adafruit/Adafruit-Bonsai-Buckaroo-PCB/Adafruit Bonsai Buckaroo.brd

## EAGLE design Adafruit Bonsai Buckaroo.brd (2020-03-19)

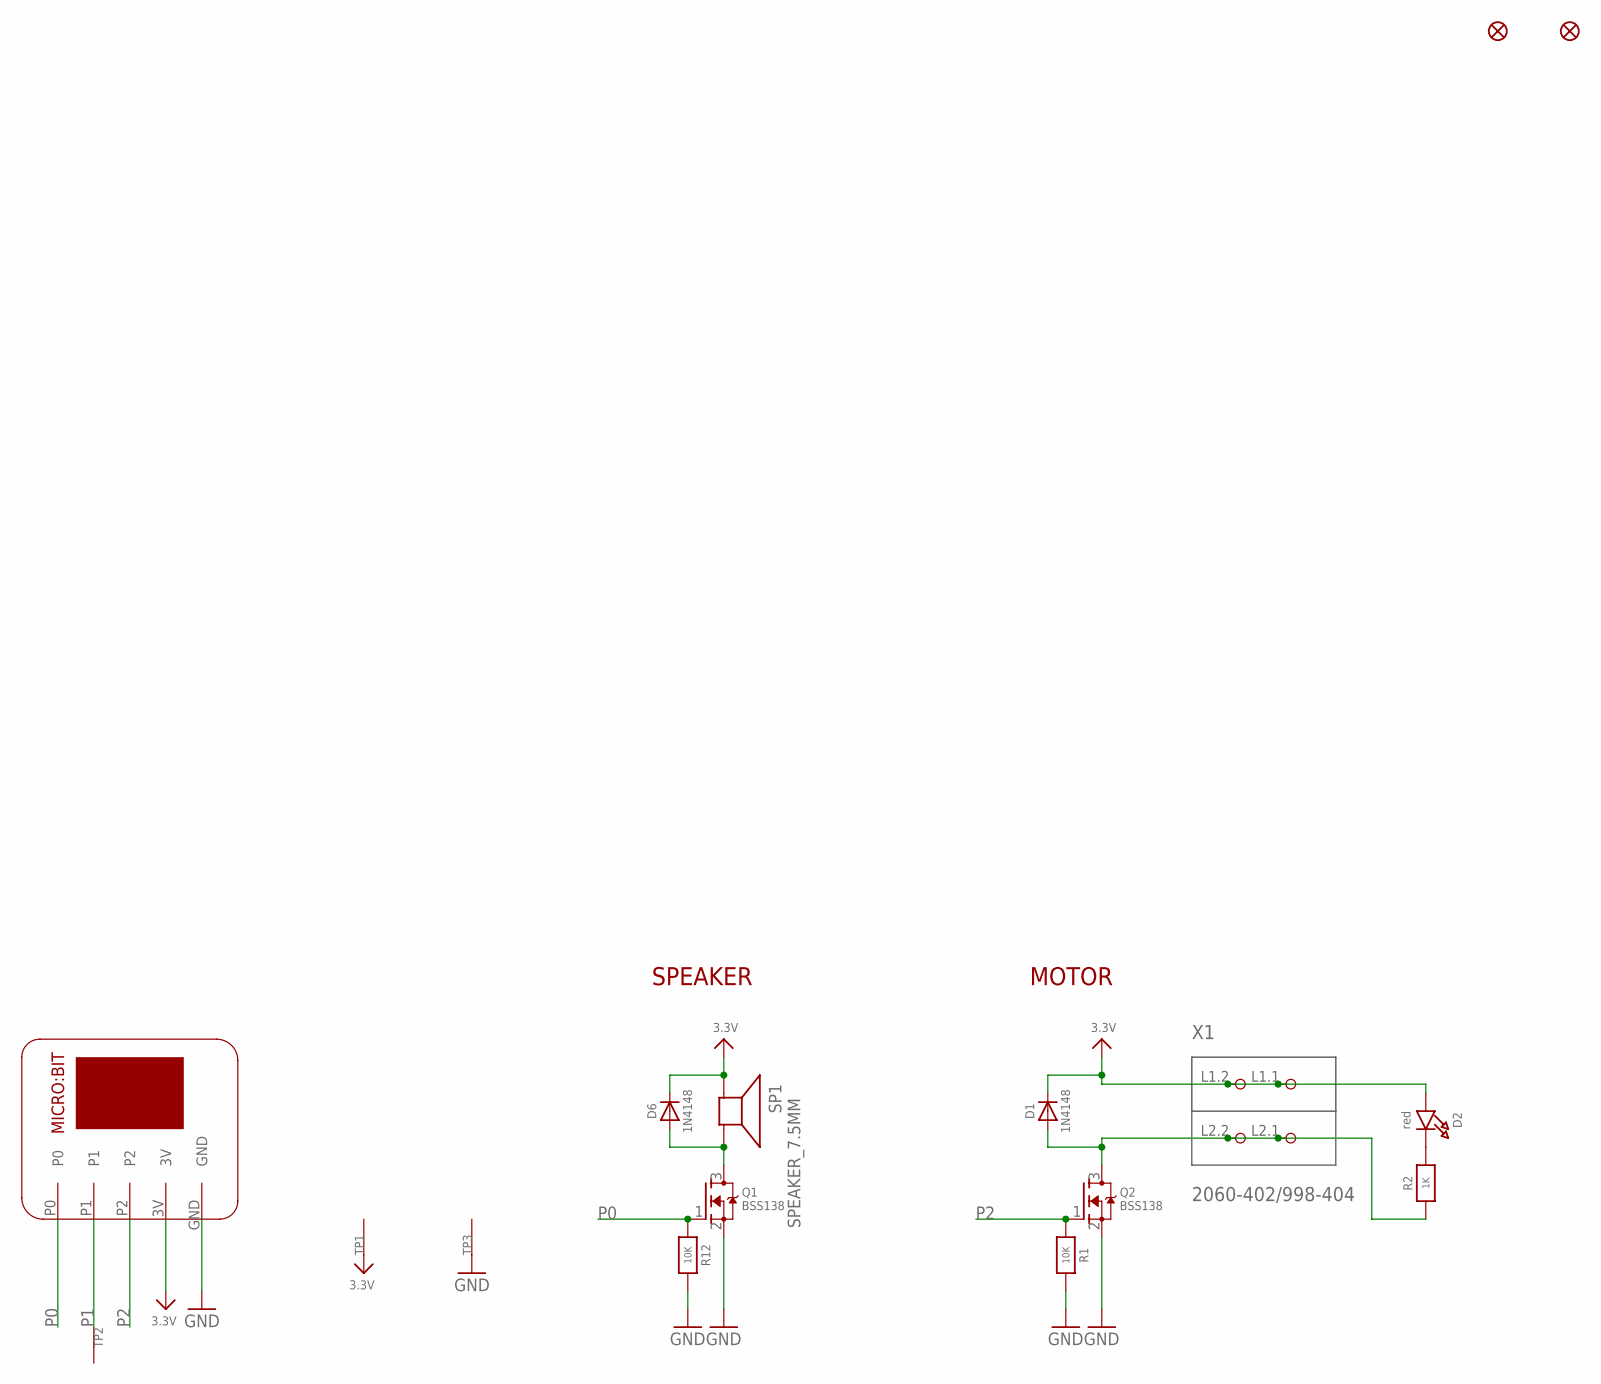
[picture p2: schematic Adafruit Bonsai Buckaroo.sch]

Parts:
D1, D6: 1N4148; SOD-323
D2: red; CHIPLED_0805_NOOUTLINE
FID1, FID2: FIDUCIAL_1MM
MB2: MICROBIT_5PIN; MICROBIT_5SMTNUT
Q1, Q2: BSS138; SOT23-WIDE
R1, R12: 10K; 0603-NO
R2: 1K; 0603-NO
SP1: SPEAKER_7.5MM; BUZZER_SMT_7.5MM
TP1, TP2, TP3: SEWTAPPCB_ALLIGATOR; PCB_ALLI
X1: 2060-402/998-404; P-2060-402/998-404

Connections:
3.3V: D1.C, D2.A, D6.C, MB2.3V, SP1.+, TP1.P$1, X1.L1.1 (P1.1), X1.L1.2 (P1.2)
GND: MB2.GND, Q1.2 (S), Q2.2 (S), R1.2, R12.2, TP3.P$1
unnamed: D1.A, Q2.3 (D), R2.1, X1.L2.1 (P2.1), X1.L2.2 (P2.2)
unnamed: D2.C, R2.2
unnamed: D6.A, Q1.3 (D), SP1.-
P0: MB2.P0, Q1.1 (G), R12.1
P1: MB2.P1, TP2.P$1
P2: MB2.P2, Q2.1 (G), R1.1

Notes on the sheet:
SPEAKER
MOTOR

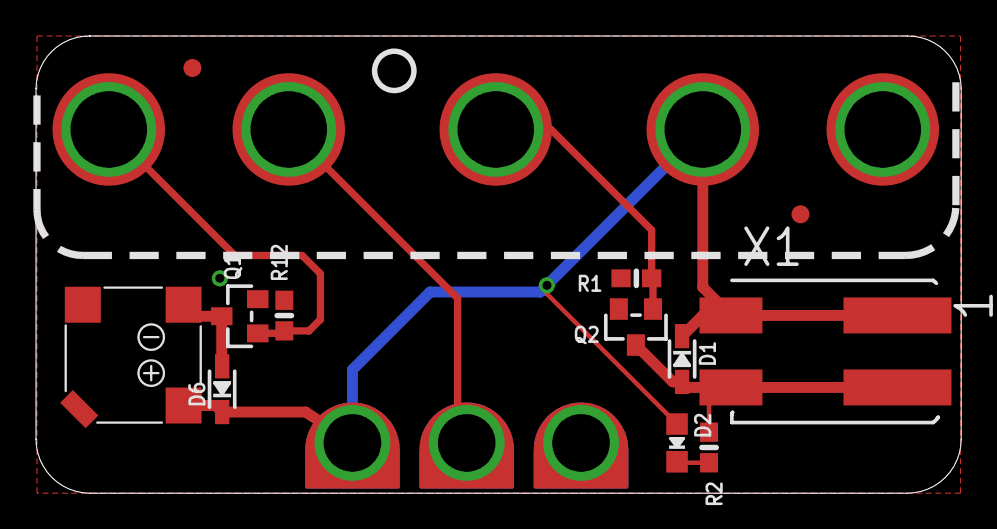
[picture p3: board Adafruit Bonsai Buckaroo.brd from above]

Board: 2 copper layers, 51.4 x 25.4 mm, 19 parts (1 on the bottom side), 8 nets.

Other parts of the board:
U$4: BONSAI_BOT
U$5: BONSAI_TOP
U$10: PCBFEAT-REV-056
